isaacwkz/Robotic-Arm-with-Moving-Platform/Mechanics/Wheel Hub.stl

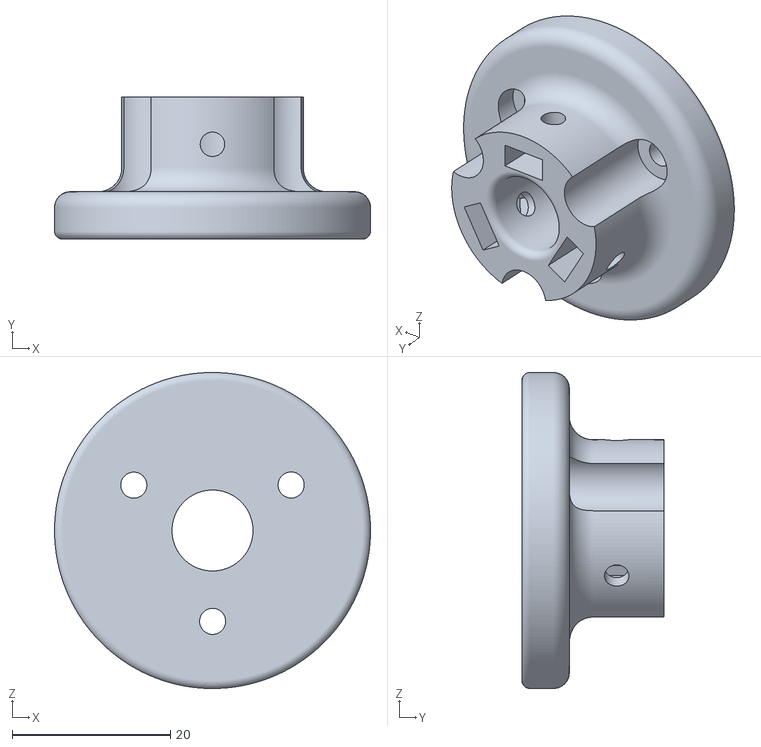
[picture p2: CAD file, 2020-05-06]
Mechanics/Wheel Hub.stl
40.0 x 18.0 x 40.0
