isaacwkz/Robotic-Arm-with-Moving-Platform/Mechanics/Double Helix Servo Gear.stl

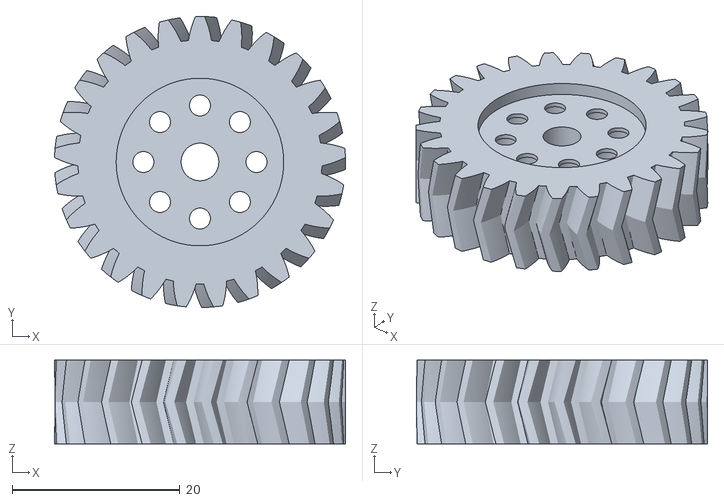
[picture p3: CAD file, 2020-04-30]
Mechanics/Double Helix Servo Gear.stl
34.7 x 34.8 x 10.0
