isaacwkz/Robotic-Arm-with-Moving-Platform/Mechanics/Swivel Joint Driver.stl

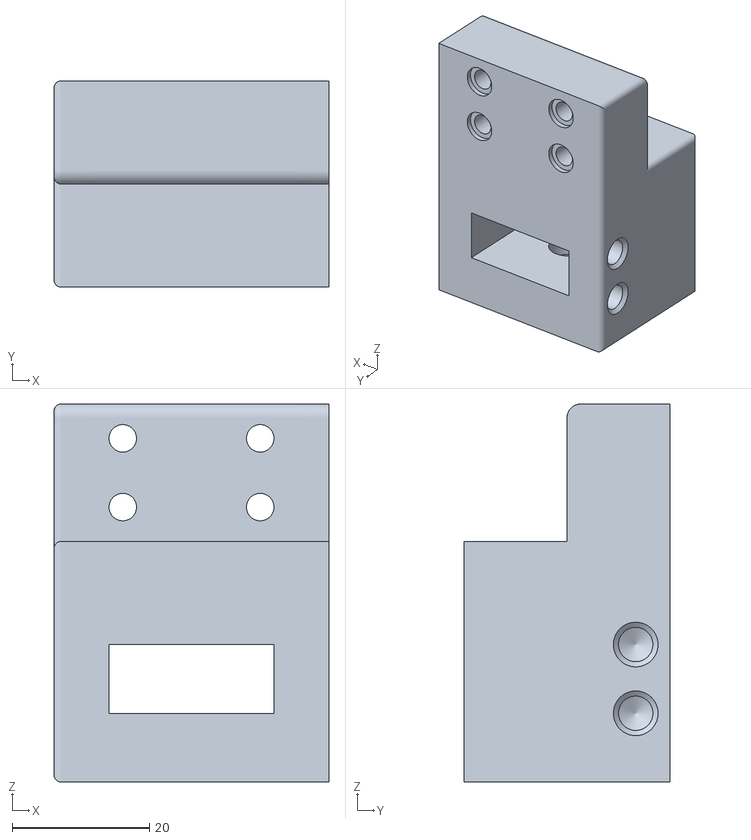
[picture p4: CAD file, 2020-04-30]
Mechanics/Swivel Joint Driver.stl
40.0 x 30.0 x 55.0
