isaacwkz/Robotic-Arm-with-Moving-Platform/Mechanics/Swivel Joint Servo Gear.stl

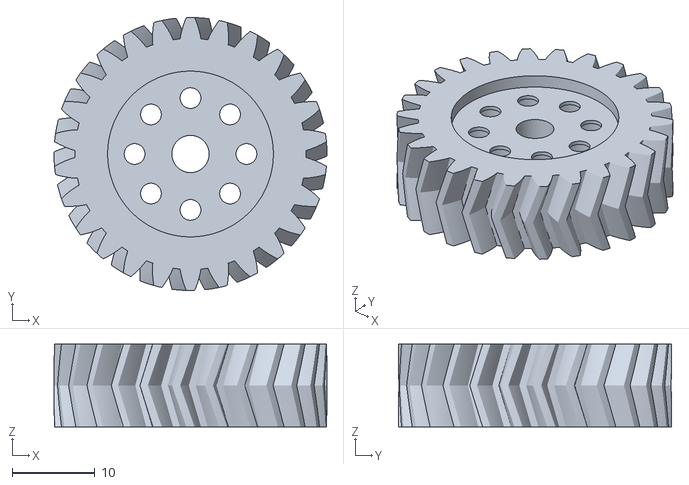
[picture p5: CAD file, 2020-04-30]
Mechanics/Swivel Joint Servo Gear.stl
32.9 x 32.9 x 10.0
