isaacwkz/Robotic-Arm-with-Moving-Platform/Mechanics/Double Helix Driven Gear.stl

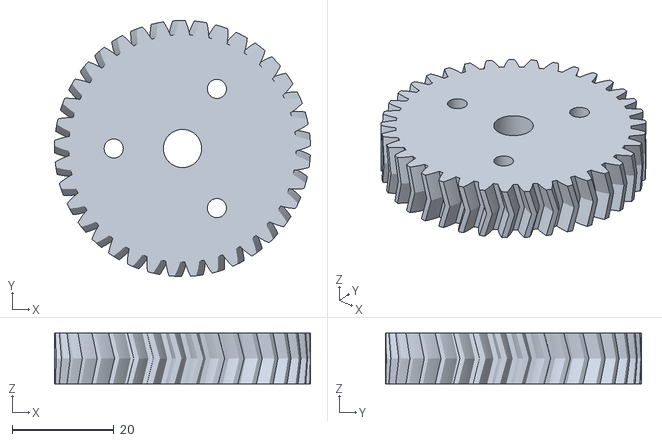
[picture p6: CAD file, 2020-04-30]
Mechanics/Double Helix Driven Gear.stl
50.2 x 50.2 x 10.0
