isaacwkz/Robotic-Arm-with-Moving-Platform/Mechanics/Swivel Arm Servo Holder.stl

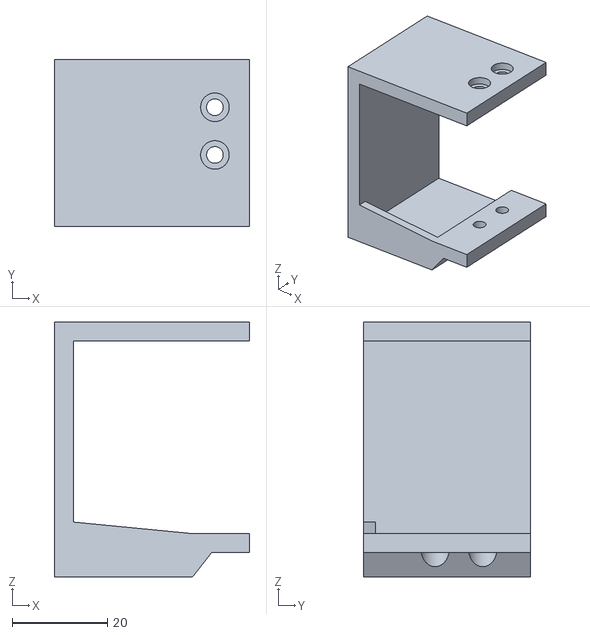
[picture p7: CAD file, 2020-04-30]
Mechanics/Swivel Arm Servo Holder.stl
41.0 x 35.0 x 53.5
