isaacwkz/Robotic-Arm-with-Moving-Platform/Mechanics/Servo Joint.stl

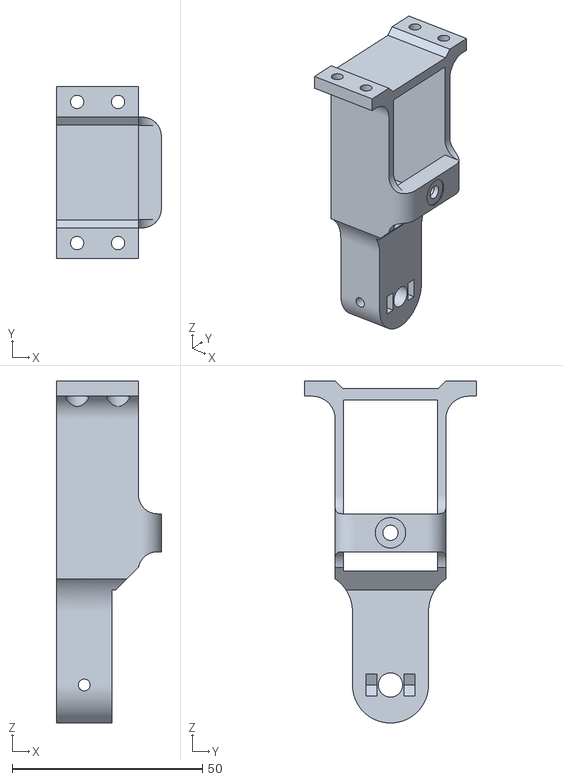
[picture p8: CAD file, 2020-04-30]
Mechanics/Servo Joint.stl
27.5 x 45.1 x 89.9
