isaacwkz/Robotic-Arm-with-Moving-Platform/Mechanics/Swivel Joint Driven.stl

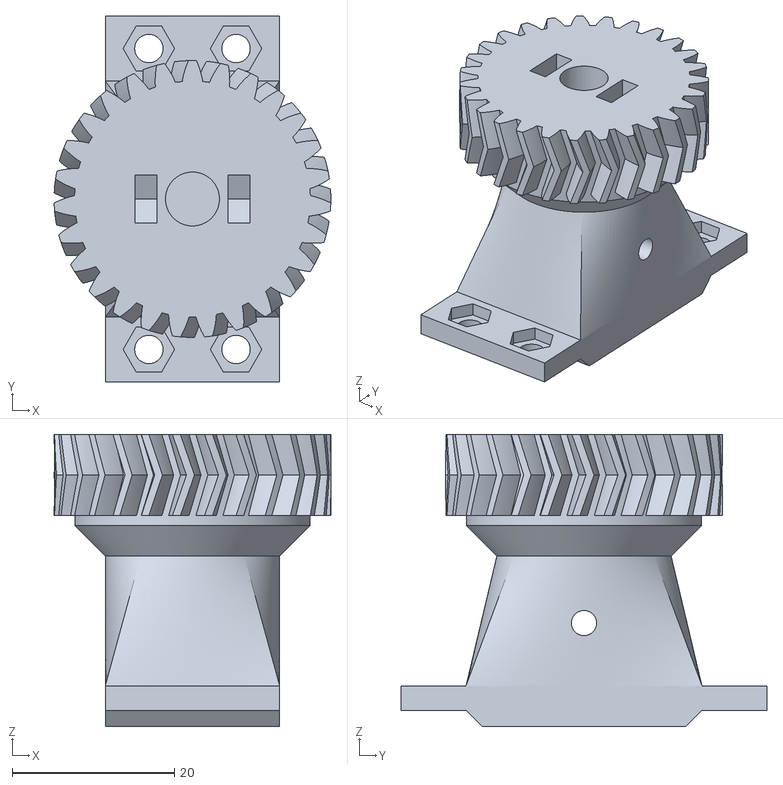
[picture p9: CAD file, 2020-04-30]
Mechanics/Swivel Joint Driven.stl
34.1 x 45.1 x 36.0
