isaacwkz/Robotic-Arm-with-Moving-Platform/Mechanics/Test Stand.stl

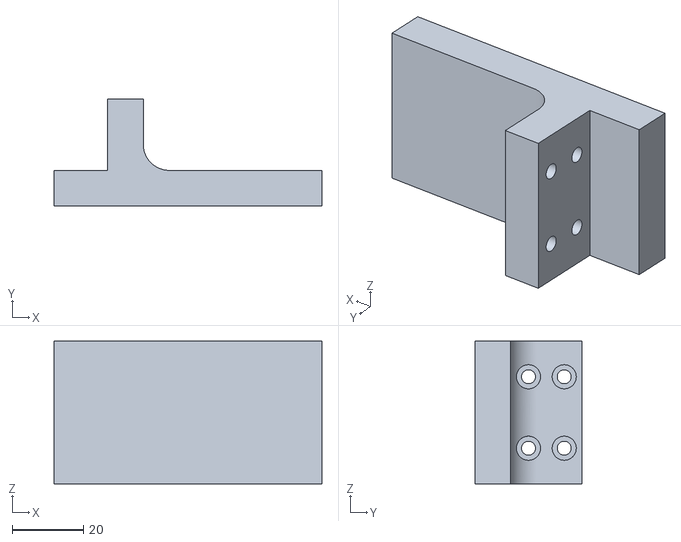
[picture p10: CAD file, 2020-04-30]
Mechanics/Test Stand.stl
75.0 x 30.0 x 40.0
