isaacwkz/Robotic-Arm-with-Moving-Platform/Mechanics/Arm Joint Brass Insert.stl

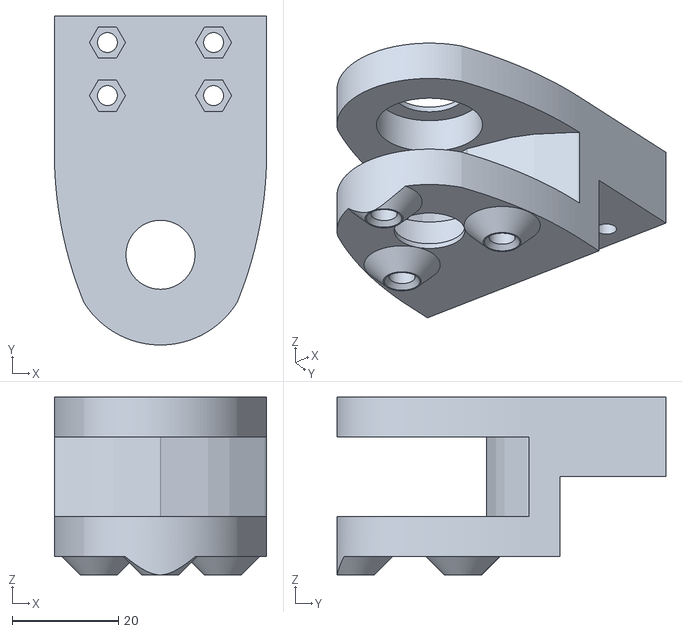
[picture p11: CAD file, 2020-04-30]
Mechanics/Arm Joint Brass Insert.stl
40.0 x 62.0 x 33.5
