isaacwkz/Robotic-Arm-with-Moving-Platform/Mechanics/Swivel Joint Axle Lock.stl

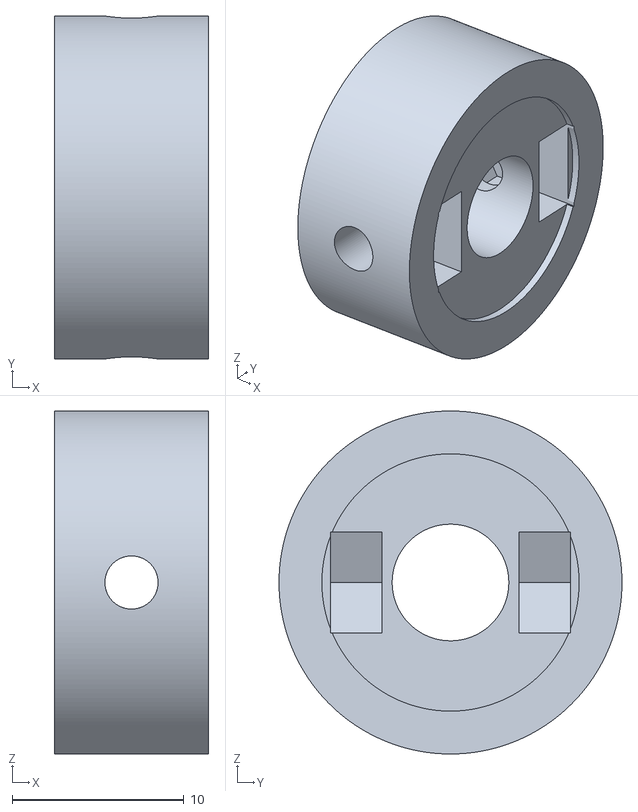
[picture p12: CAD file, 2020-04-30]
Mechanics/Swivel Joint Axle Lock.stl
9.00 x 20.0 x 20.0
