isaacwkz/Robotic-Arm-with-Moving-Platform/Mechanics/Driven Gear.stl

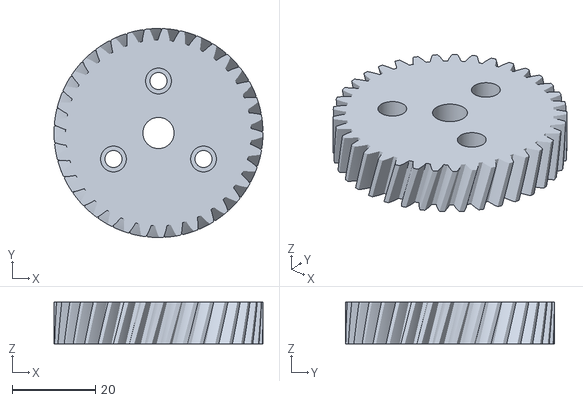
[picture p13: CAD file, 2020-04-30]
Mechanics/Driven Gear.stl
50.2 x 50.2 x 10.0
