isaacwkz/Robotic-Arm-with-Moving-Platform/Mechanics/Servo Gear.stl

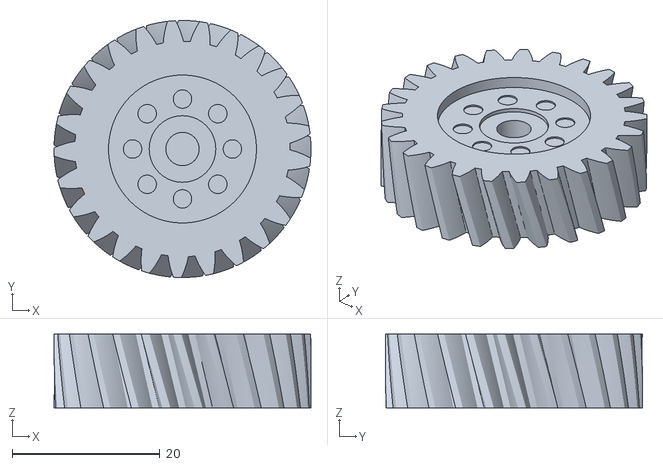
[picture p14: CAD file, 2020-04-30]
Mechanics/Servo Gear.stl
34.8 x 34.8 x 10.0
