isaacwkz/Robotic-Arm-with-Moving-Platform/(list of files, cad)

Other CAD files:
Mechanics/Driven Gear M4.stl
Mechanics/Arm Joint.stl
Mechanics/Arm Joint Brass Insert.ipt
Mechanics/Arm Joint.ipt
Mechanics/Assembly.iam
Mechanics/Double Helix Driven Gear.ipt
Mechanics/Double Helix Servo Gear.ipt
Mechanics/Driven Gear M4.ipt
Mechanics/Driven Gear.ipt
Mechanics/Gear Joint.iam
Mechanics/LX-16A.ipt
Mechanics/OldVersions/Arm Joint Brass Insert.0001.ipt
Mechanics/OldVersions/Arm Joint.0007.ipt
Mechanics/OldVersions/Assembly.0012.iam
Mechanics/OldVersions/Double Helix Driven Gear M4.0005.ipt
Mechanics/OldVersions/Double Helix Driven Gear.0001.ipt
Mechanics/OldVersions/Double Helix Servo Gear.0001.ipt
Mechanics/OldVersions/Driven Gear M4.0004.ipt
Mechanics/OldVersions/Driven Gear.0002.ipt
Mechanics/OldVersions/Servo Gear.0008.ipt
Mechanics/OldVersions/Servo Joint.0012.ipt
Mechanics/OldVersions/Swivel Arm Servo Holder.0004.ipt
Mechanics/OldVersions/Swivel Joint Axle Lock Grub Screw.0001.ipt
Mechanics/OldVersions/Swivel Joint Axle Lock Side A.0004.ipt
Mechanics/OldVersions/Swivel Joint Axle Lock Side B.0002.ipt
Mechanics/OldVersions/Swivel Joint Axle Lock.0004.ipt
Mechanics/OldVersions/Swivel Joint Driven Axle Lock.0001.ipt
Mechanics/OldVersions/Swivel Joint Driven Axle Lock.0002.ipt
Mechanics/OldVersions/Swivel Joint Driven.0008.ipt
Mechanics/OldVersions/Swivel Joint Driver.0003.ipt
Mechanics/OldVersions/Swivel Joint Driver.0005.ipt
Mechanics/OldVersions/Swivel Joint Gears.0001.iam
Mechanics/OldVersions/Swivel Joint Servo Gear.0003.ipt
Mechanics/OldVersions/Wheel Hub.0007.ipt
Mechanics/Servo Gear.ipt
Mechanics/Servo Joint.ipt
Mechanics/Swivel Arm Servo Assembly.iam
Mechanics/Swivel Arm Servo Holder.ipt
Mechanics/Swivel Joint Axle Lock Grub Screw.ipt
Mechanics/Swivel Joint Driven Gear.ipt
Mechanics/Swivel Joint Driven.ipt
Mechanics/Swivel Joint Driver.ipt
Mechanics/Swivel Joint Gears.iam
Mechanics/Swivel Joint Servo Gear.ipt
Mechanics/Test Stand.ipt
Mechanics/Wheel Hub.ipt
Mechanics/joint.iam
