isaacwkz/Robotic-Arm-with-Moving-Platform/Electronics/Hardware/PCB Schematics/Robot Controller R2.pdf

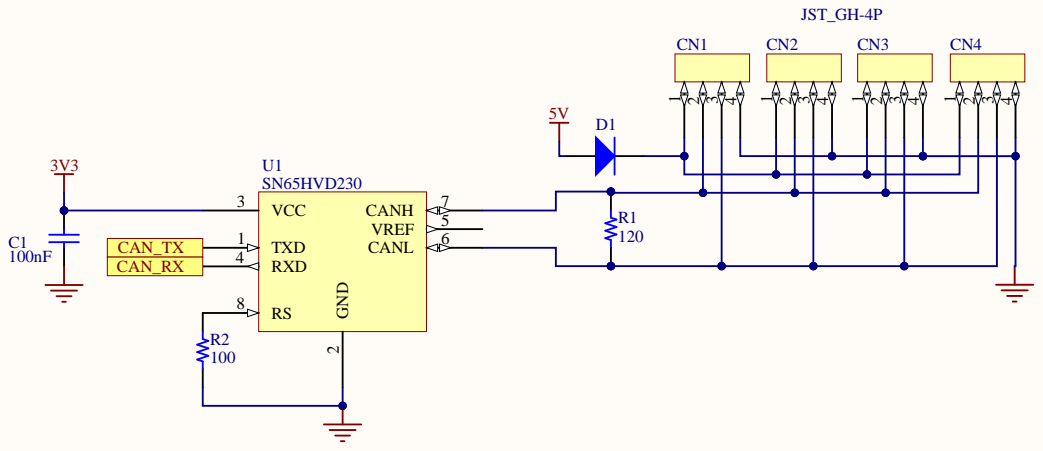
[picture p15: page 1]

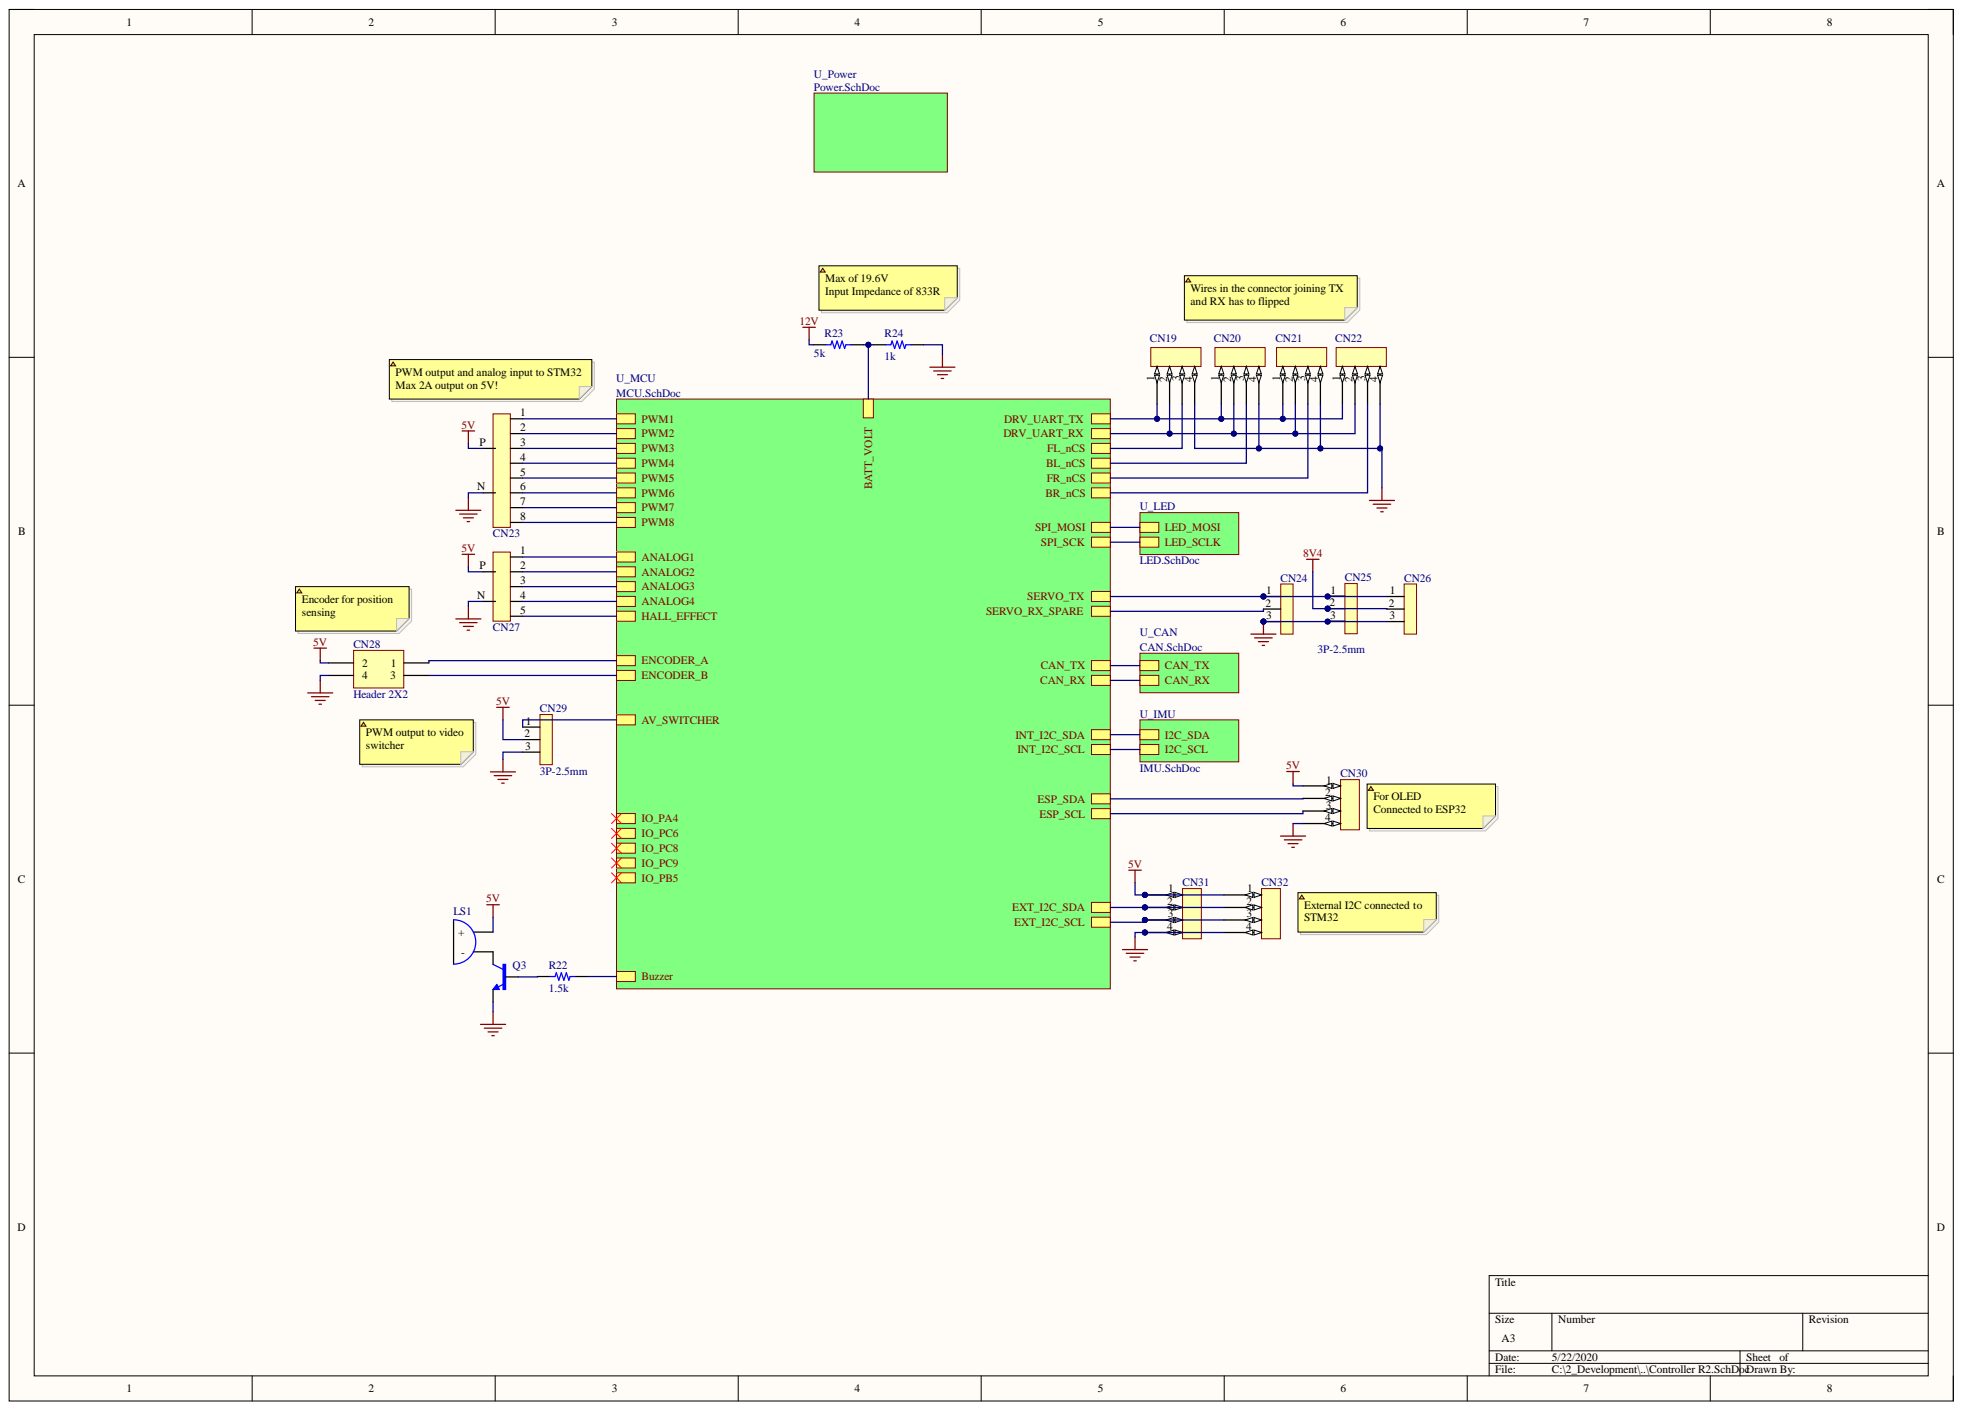
[picture p16: page 2]

Wires in the connector joining TX
and RX has to flipped

PWM output and analog input to STM32
Max 2A output on 5V!

2 | LED.SchDoc
3 | | CN25

PWM output to video
switcher

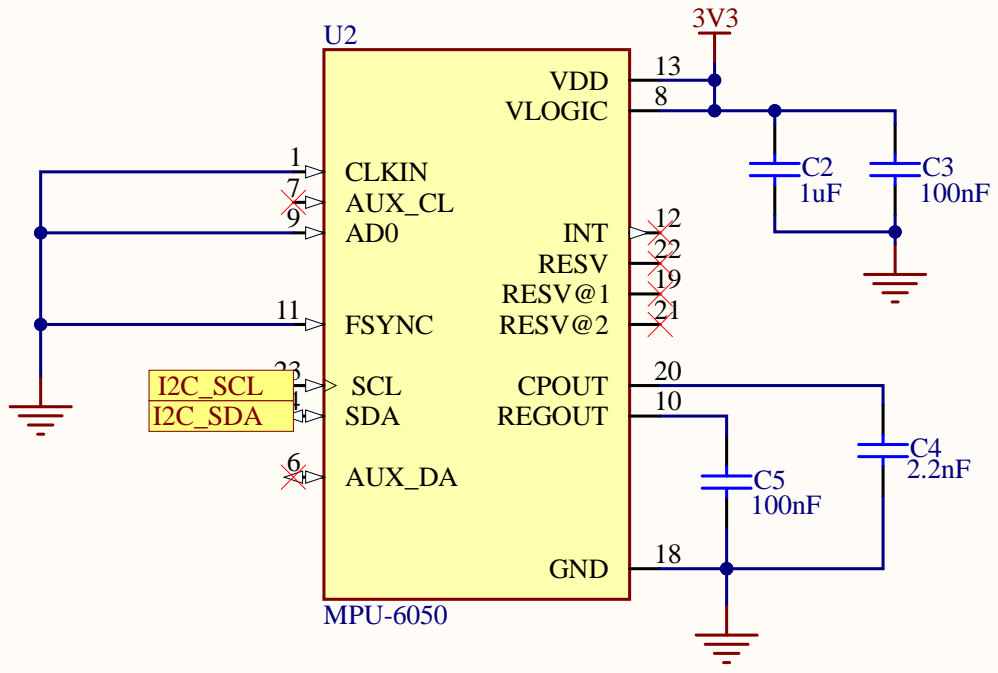
[picture p17: page 3]

I2C_SCL

SCL 23

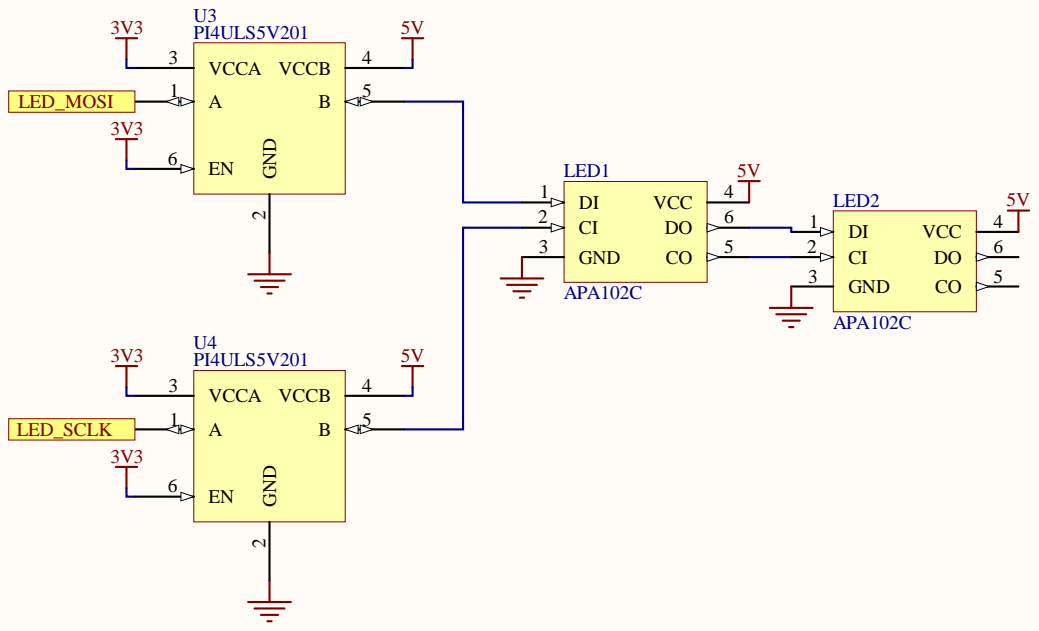
[picture p18: page 4]

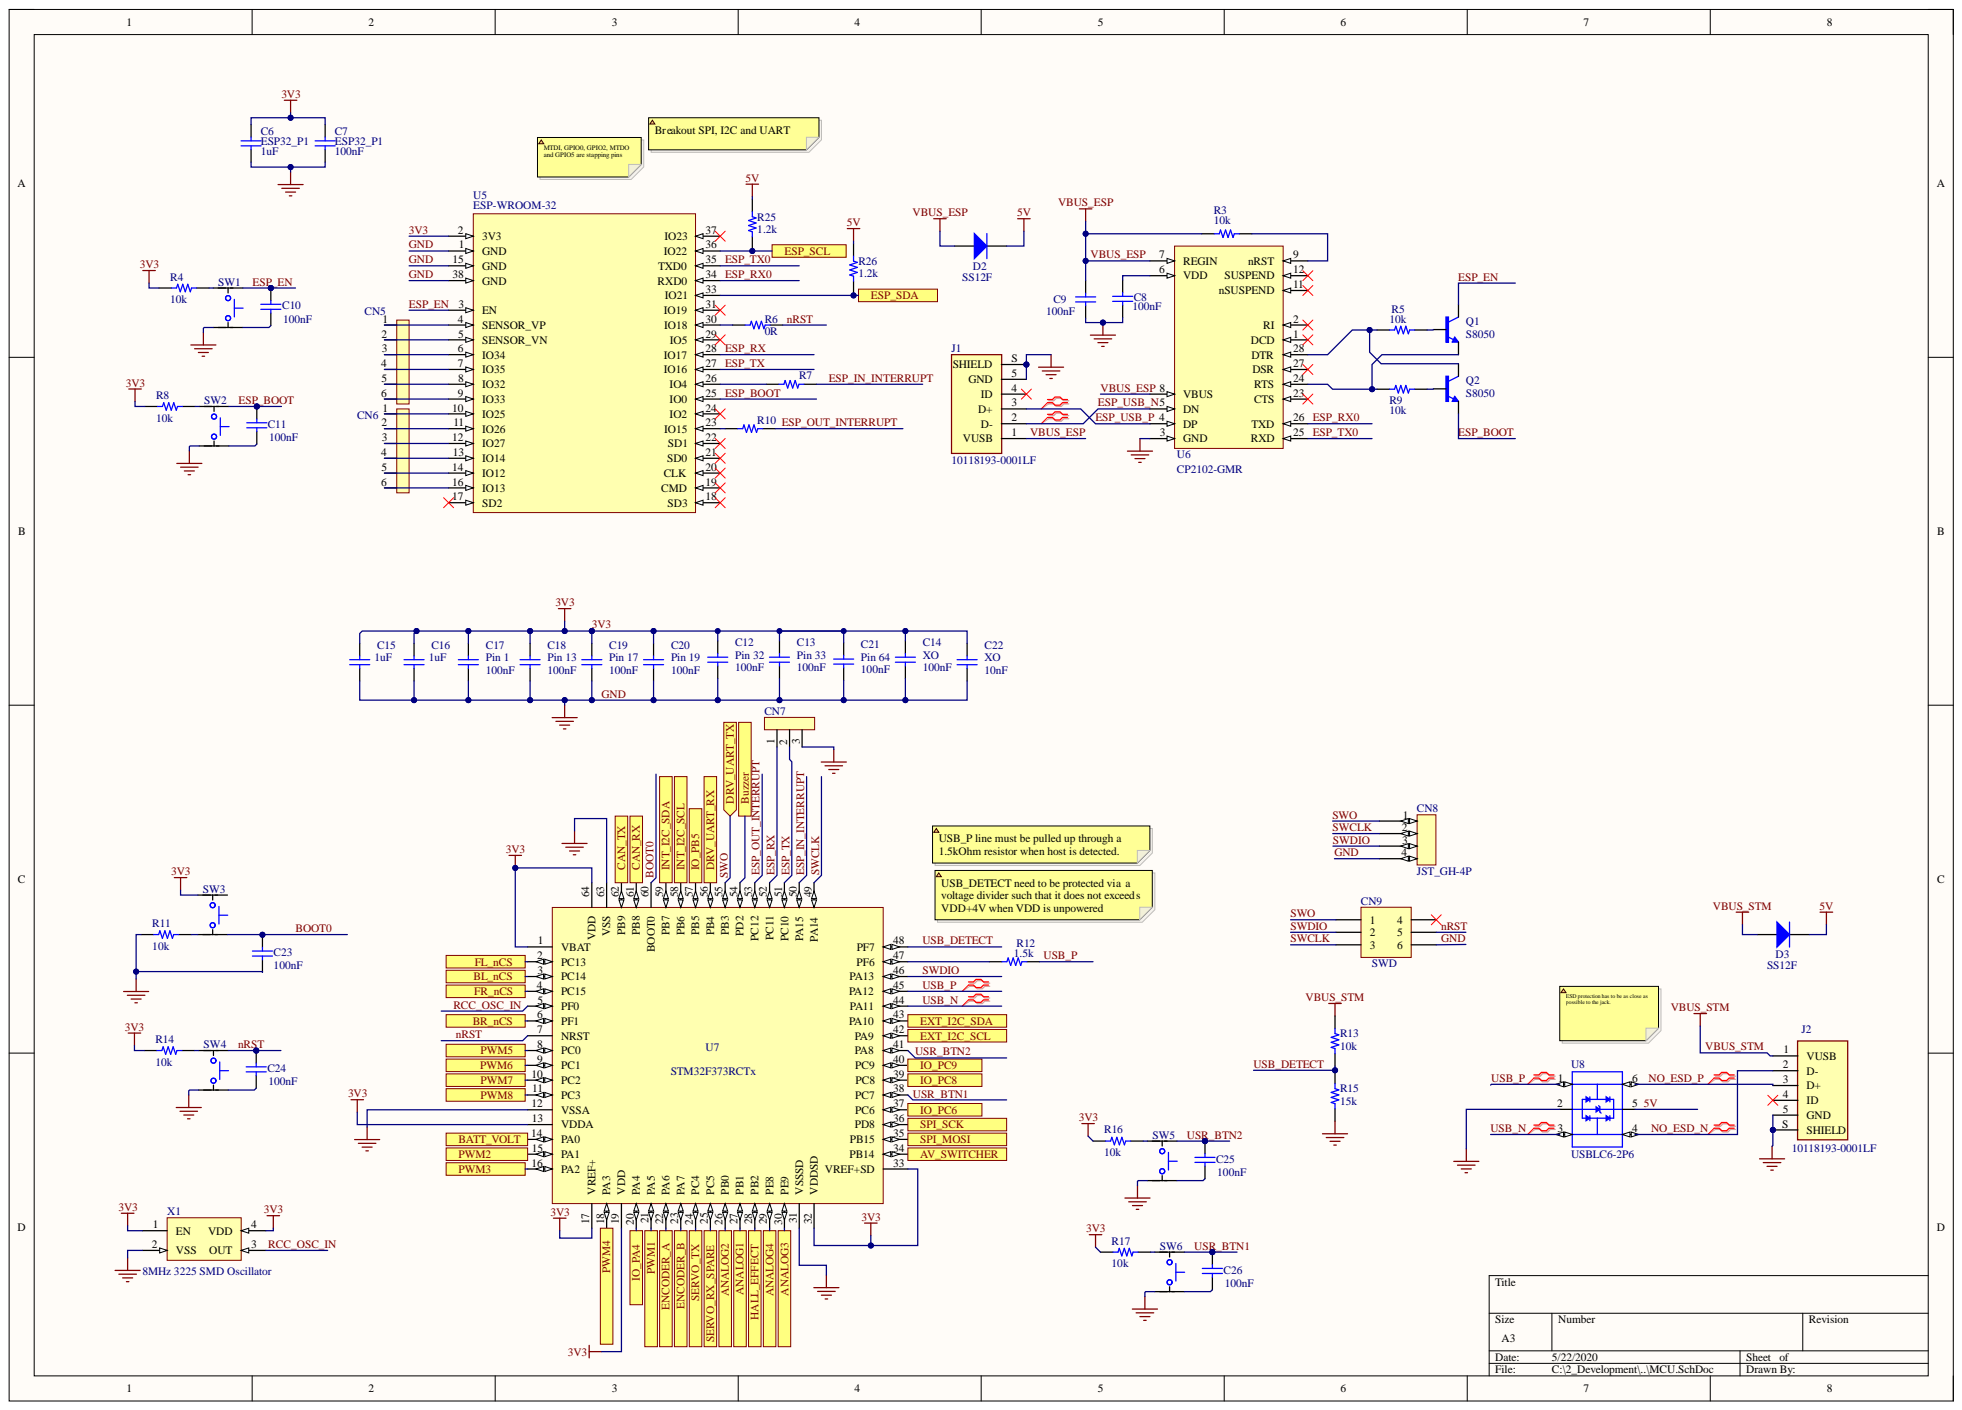
[picture p19: page 5]

Breakout SPI, I2C and UART

MTDI, GPIO0, GPIO2, MTDO
and GPIO5 are stapping pins

USB_P line must be pulled up through a
1.5kOhm resistor when host is detected.

USB_DETECT need to be protected via a
voltage divider such that it does not exceeds
VDD+4V when VDD is unpowered

BL_nCS | PC15 4

ESD protection has to be as close as
possible to the jack.

BATT_VOLT | SPI_MOSI
PWM2 | AV_SWITCHER

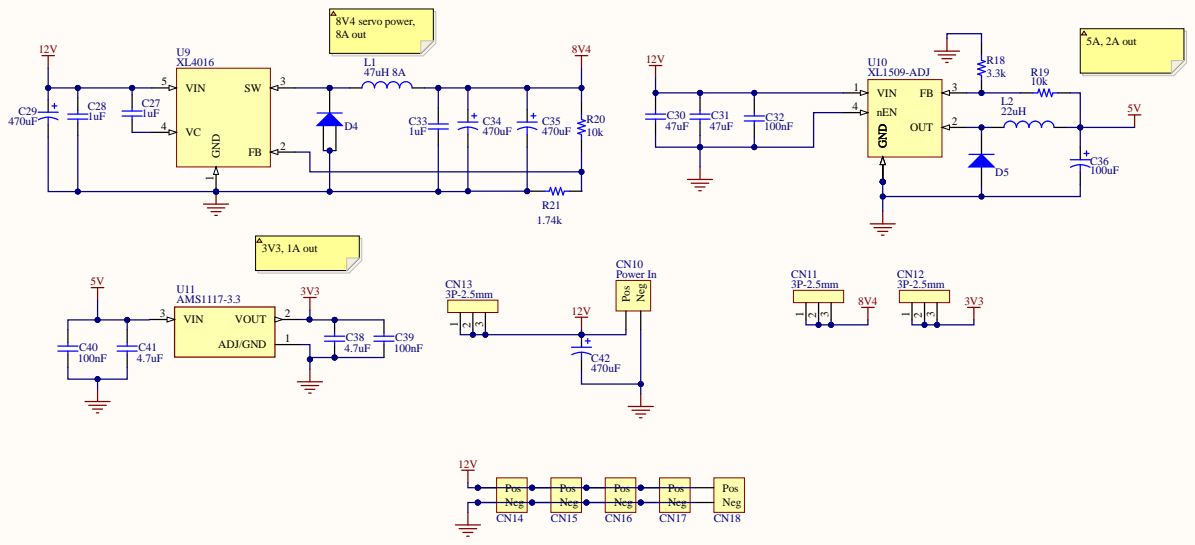
[picture p20: page 6]

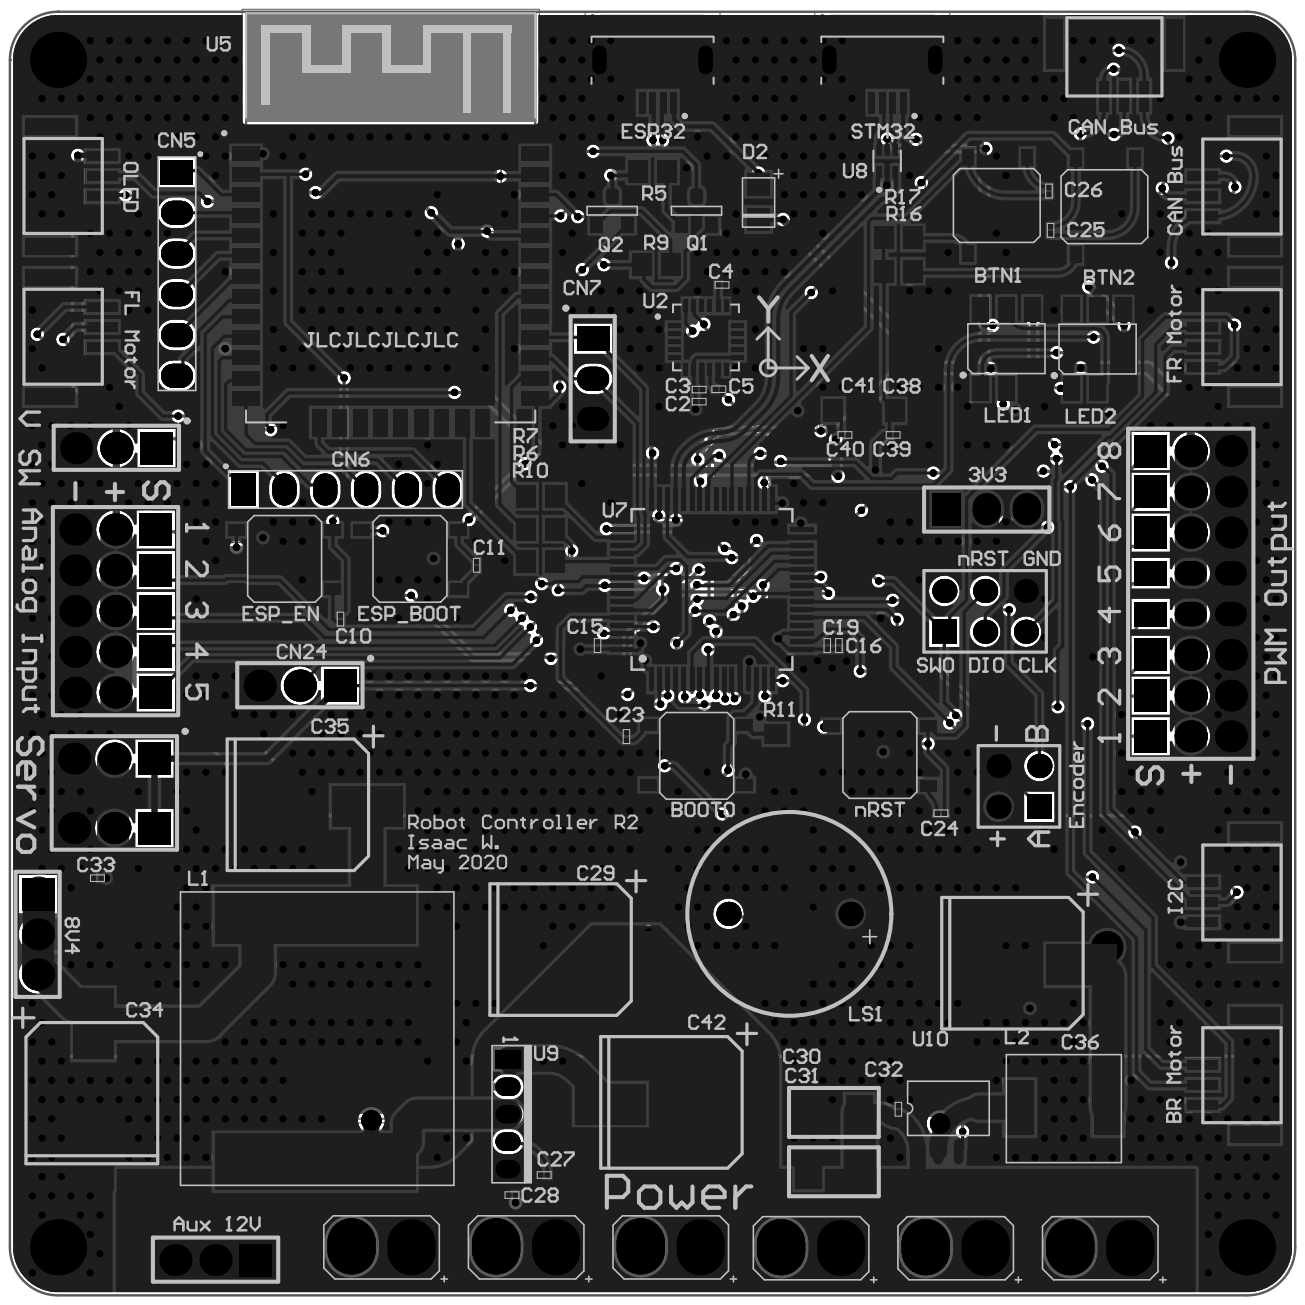
[picture p21: page 7]
