isaacwkz/Robotic-Arm-with-Moving-Platform/Electronics/Hardware/PCB Schematics/DC_ESC.pdf

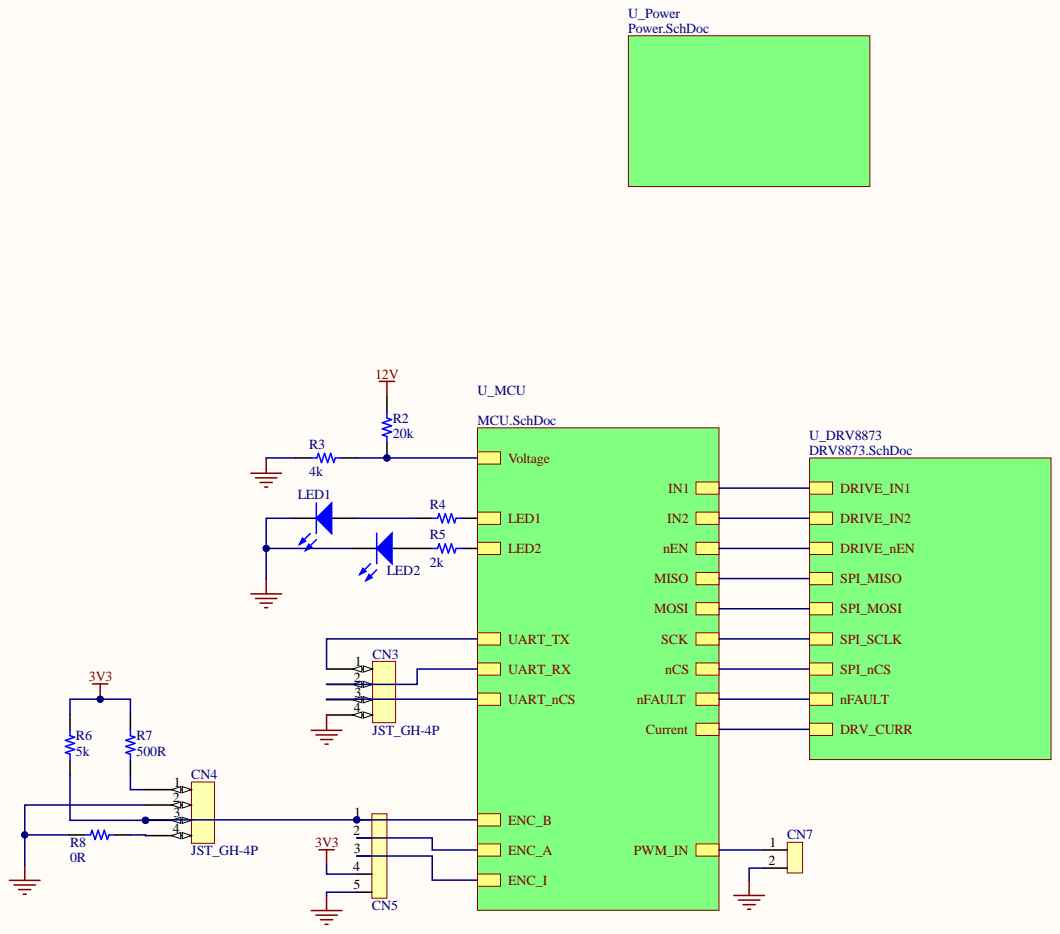
[picture p22: page 1]

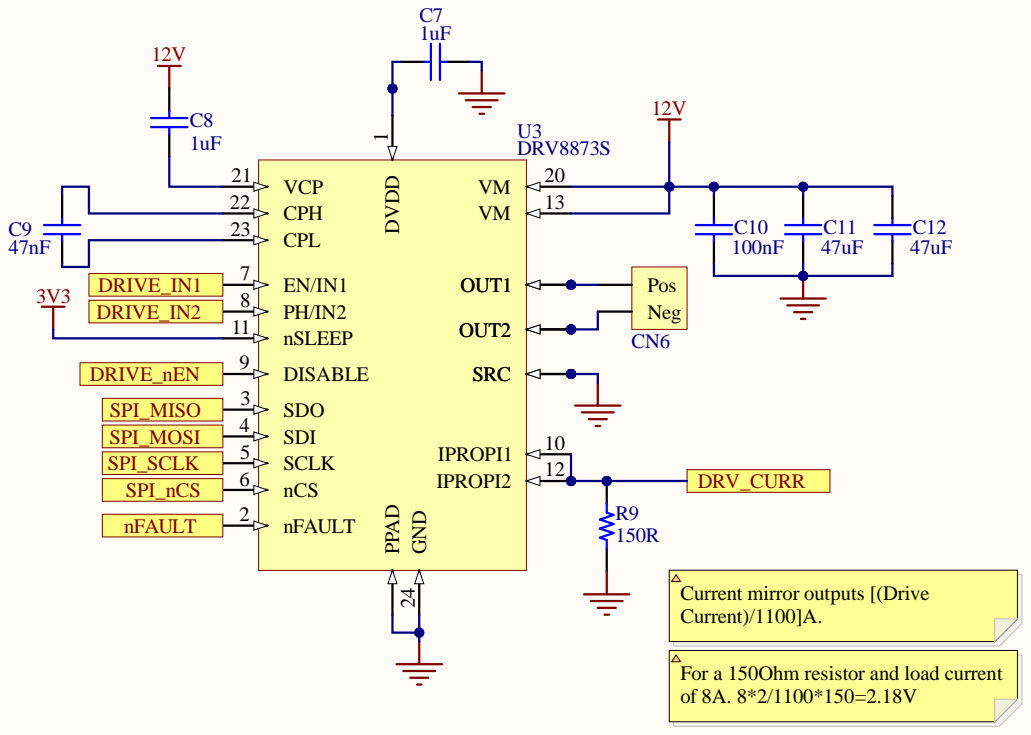
[picture p23: page 2]

DISABLE 9

DRIVE_nEN | SDO 3
SPI_MISO | SDI 4

SPI_nCS | | nFAULT 2

nCS 6 | | DRV_CURR

Current mirror outputs [(Drive
Current)/1100]A.

For a 150Ohm resistor and load current

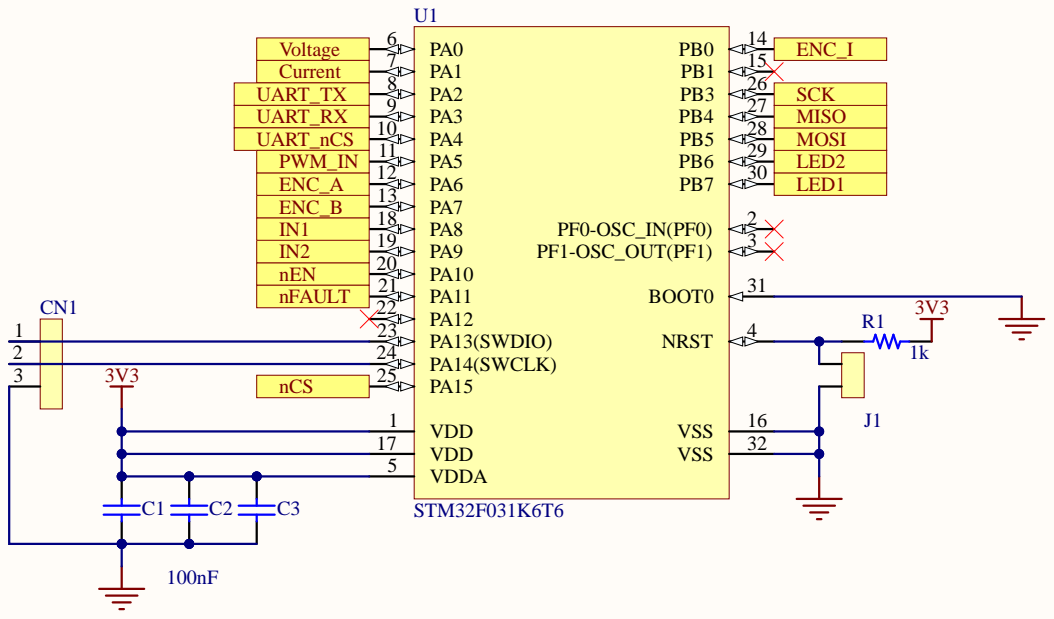
[picture p24: page 3]

UA RT_nCS | MOS I
PWM_I N | LED1 LED2

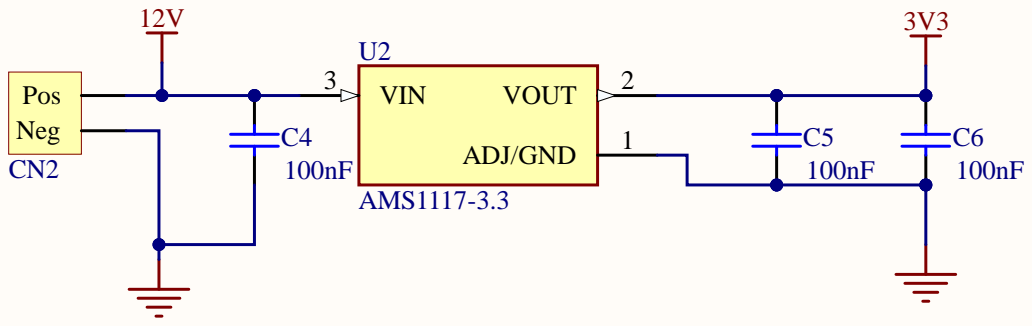
[picture p25: page 4]

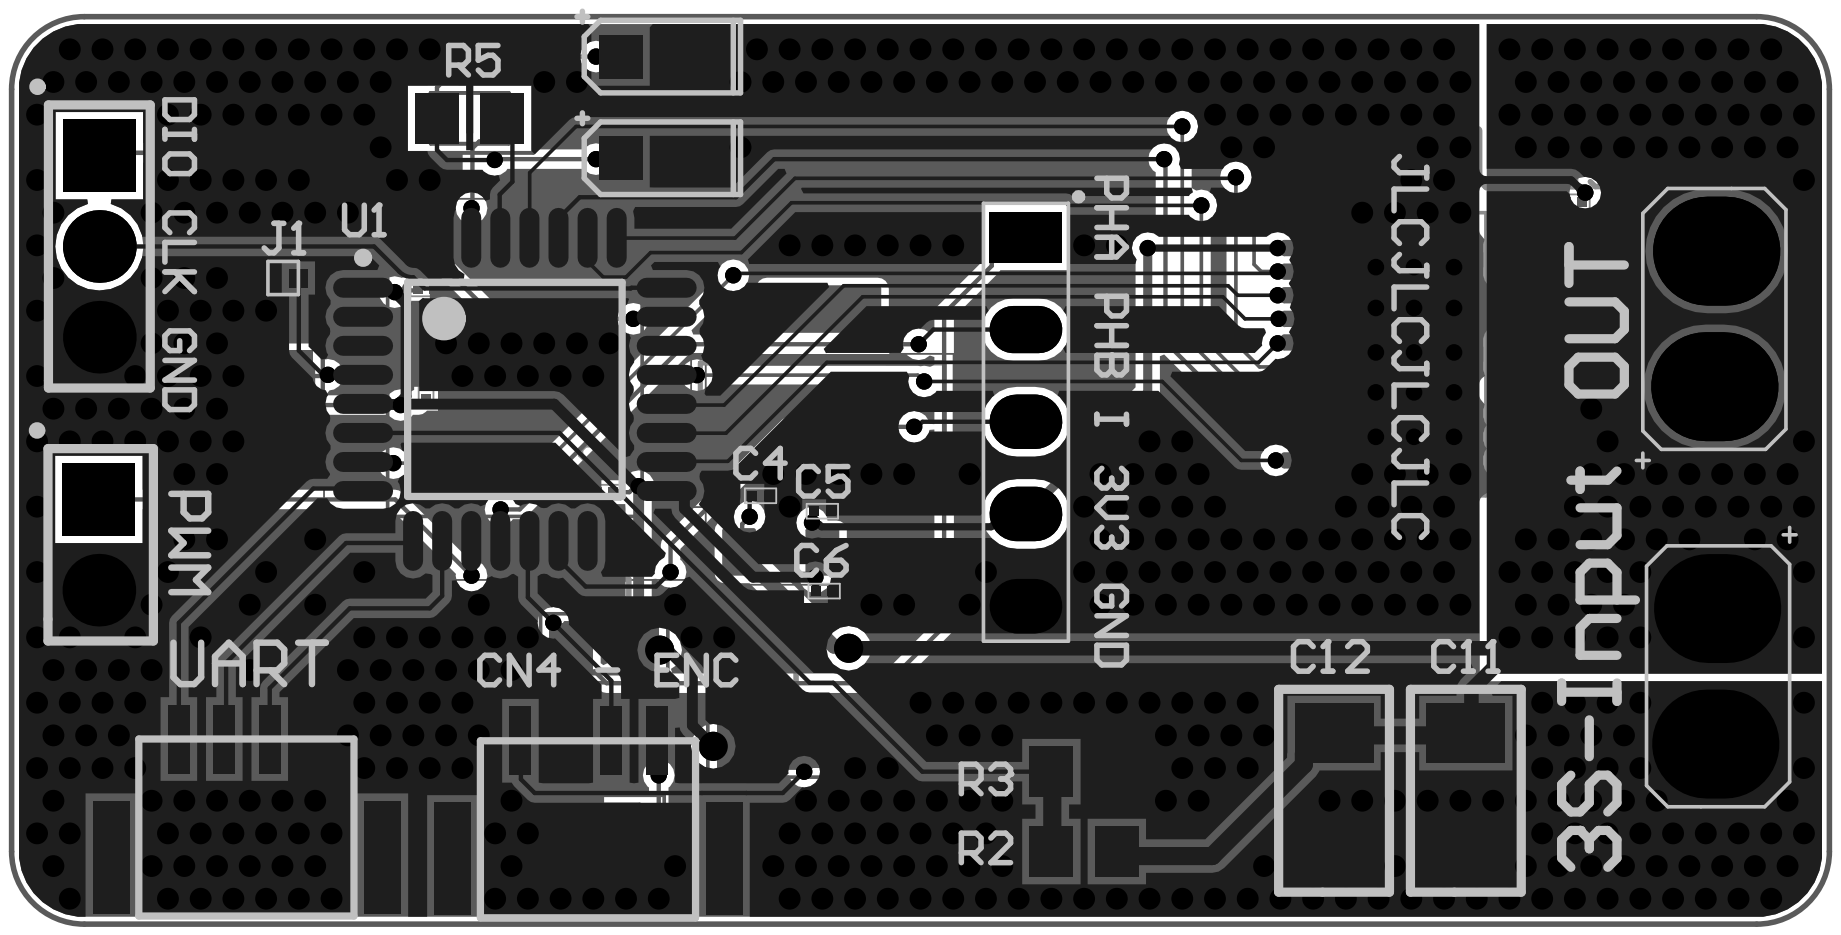
[picture p26: page 5]
