isaacwkz/Robotic-Arm-with-Moving-Platform/(list of files, drawings)

Other design files:
Electronics/Hardware/Controller R1/CAN.SchDoc
Electronics/Hardware/Controller R1/Controller.PcbDoc
Electronics/Hardware/Controller R1/Controller.SchDoc
Electronics/Hardware/Controller R1/Drive.SchDoc
Electronics/Hardware/Controller R1/DRV8843.SchDoc
Electronics/Hardware/Controller R1/IMU.SchDoc
Electronics/Hardware/Controller R1/LED.SchDoc
Electronics/Hardware/Controller R1/MCU.SchDoc
Electronics/Hardware/Controller R1/Power.SchDoc
Electronics/Hardware/Controller R1/Robot Controller.PrjPCB
Electronics/Hardware/Controller R1/Symbols and Footprints/Parts.PcbLib
Electronics/Hardware/Controller R1/Symbols and Footprints/Parts.SchLib
Electronics/Hardware/Controller R1/TMC7300.SchDoc
Electronics/Hardware/Controller R2/CAN.SchDoc
Electronics/Hardware/Controller R2/Controller R2.PcbDoc
Electronics/Hardware/Controller R2/Controller R2.PrjPcb
Electronics/Hardware/Controller R2/Controller R2.SchDoc
Electronics/Hardware/Controller R2/IMU.SchDoc
Electronics/Hardware/Controller R2/LED.SchDoc
Electronics/Hardware/Controller R2/MCU.SchDoc
Electronics/Hardware/Controller R2/Power.SchDoc
Electronics/Hardware/Controller R2/Symbols and Footprints/Imported ESP-WROOM-32.lia/ESP-WROOM-32.PcbLib
Electronics/Hardware/Controller R2/Symbols and Footprints/Imported ESP-WROOM-32.lia/ESP-WROOM-32.SchLib
Electronics/Hardware/Controller R2/Symbols and Footprints/Parts.PcbLib
Electronics/Hardware/Controller R2/Symbols and Footprints/Parts.SchLib
Electronics/Hardware/DC_ESC/DC_ESC.PrjPcb
Electronics/Hardware/DC_ESC/DRV8873.SchDoc
Electronics/Hardware/DC_ESC/ESC.PcbDoc
Electronics/Hardware/DC_ESC/ESC.SchDoc
Electronics/Hardware/DC_ESC/MCU.SchDoc
Electronics/Hardware/DC_ESC/Power.SchDoc
Electronics/Hardware/DC_ESC/Symbols and Footprints/Parts.PcbLib
Electronics/Hardware/DC_ESC/Symbols and Footprints/Parts.SchLib
