isaacwkz/Robotic-Arm-with-Moving-Platform/Electronics/Software/Controller/Controller.ioc

Mcu.UserName=STM32F373RCTx
PA0.GPIO_Label=BATT_VOLT
PA0.Signal=ADC1_IN0
PA1.GPIO_Label=PWM2
PA1.Signal=S_TIM2_CH2
PA10.GPIO_Label=EXT_I2C_SDA
PA10.Signal=I2C2_SDA
PA11.Signal=USB_DM
PA12.Signal=USB_DP
PA13.Signal=SYS_JTMS-SWDIO
PA14.Signal=SYS_JTCK-SWCLK
PA15.GPIO_Label=ESP_IN_INTERRUPT
PA15.Signal=GPXTI15
PA2.GPIO_Label=PWM3
PA2.Signal=S_TIM2_CH3
PA3.GPIO_Label=PWM4
PA3.Signal=S_TIM2_CH4
PA5.GPIO_Label=PWM1
PA5.Signal=S_TIM2_CH1_ETR
PA6.GPIO_Label=ENCODER_A
PA6.Signal=S_TIM3_CH1
PA7.GPIO_Label=ENCODER_B
PA7.Signal=S_TIM3_CH2
PA8.GPIO_Label=USR_BTN2
PA8.Signal=GPIO_Input
PA9.GPIO_Label=EXT_I2C_SCL
PA9.Signal=I2C2_SCL
PB0.GPIO_Label=ANALOG2
PB0.Signal=SDADC1_AIN6P
PB1.GPIO_Label=ANALOG1
PB1.Signal=SDADC1_AIN5P
PB14.GPIO_Label=AV_SWITCHER
PB14.Signal=S_TIM12_CH1
PB15.GPIO_Label=SPI_MOSI
PB15.Signal=SPI2_MOSI
PB2.GPIO_Label=HALL_EFFECT
PB2.Signal=SDADC1_AIN4P
PB3.GPIO_Label=DRIVE_UART_TX
PB3.Signal=USART2_TX
PB4.GPIO_Label=DRIVE_UART_RX
PB4.Signal=USART2_RX
PB6.GPIO_Label=INT_I2C_SCL
PB6.Signal=I2C1_SCL
PB7.GPIO_Label=INT_I2C_SDA
PB7.Signal=I2C1_SDA
PB8.Signal=CAN_RX
PB9.Signal=CAN_TX
PC0.GPIO_Label=PWM5
PC0.Signal=S_TIM5_CH1_ETR
PC1.GPIO_Label=PWM6
PC1.Signal=S_TIM5_CH2
PC10.GPIO_Label=ESP_TX
PC10.Signal=USART3_TX
PC11.GPIO_Label=ESP_RX
PC11.Signal=USART3_RX
PC12.GPIO_Label=ESP_OUT_INTERRUPT
PC12.Signal=GPIO_Output
PC13.GPIO_Label=FL_nCS
PC13.Signal=GPIO_Output
PC14-OSC32_IN.Signal=GPIO_Output
PC15-OSC32_OUT.GPIO_Label=FR_nCS
PC15-OSC32_OUT.Signal=GPIO_Output
PC2.GPIO_Label=PWM7
PC2.Signal=S_TIM5_CH3
PC3.GPIO_Label=PWM8
PC3.Signal=S_TIM5_CH4
PC4.GPIO_Label=SERVO_TX
PC4.Signal=USART1_TX
PC5.GPIO_Label=SERVO_RX_SPARE
PC5.Signal=GPIO_Analog
PC7.Signal=GPIO_Input
PD2.GPIO_Label=Buzzer
PD2.Signal=GPIO_Output
PD8.GPIO_Label=SPI_SCK
PD8.Signal=SPI2_SCK
PE8.GPIO_Label=ANALOG4
PE8.Signal=SDADC1_AIN8P
PE9.GPIO_Label=ANALOG3
PE9.Signal=SDADC1_AIN7P
PF0-OSC_IN.Signal=RCC_OSC_IN
PF1-OSC_OUT.GPIO_Label=BR_nCS
PF1-OSC_OUT.Signal=GPIO_Output
PF6.GPIO_Label=USB_DP_PULLUP
PF6.Signal=GPIO_Output
PF7.GPIO_Label=USB_DETECT
PF7.Signal=GPIO_Output
