isaacwkz/Robotic-Arm-with-Moving-Platform/(commit log)

2020-05-01 Added PDF export of PCB
    [Copy of Controller.PcbDoc]
2020-05-02 Updateed PCB Clearances
    [Robot Controller.PrjPCB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]
2020-05-06 unrouted PCB, added screenshots of mechanics
    [Robot Controller.PrjPCB, Wheel Hub.0007.ipt, Wheel Hub.ipt, Wheel Hub.stl]
2020-05-06 scraped pcb
    [Controller.PcbDoc, Parts.PcbLib]
2020-05-13 PCB edits
    Old controller has been scraped (marked as R1)
    Motor drivers has been seperated out on a different PCB.
    [CAN.SchDoc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]
2020-05-15 PCB edits
    [CAN.SchDoc, Controller R2.PcbDoc, Controller R2.PrjPcb, Controller R2.SchDoc, ESP-WROOM-32.PcbLib, ESP-WROOM-32.SchLib, IMU.SchDoc, LED.SchDoc]
2020-05-15 more PCB edtis
    [Controller R2.PcbDoc, Controller R2.PrjPcb, MCU.SchDoc]
2020-05-20 PCB edits before changing to a 4 layer stackup
    [Controller R2.SchDoc, Parts.PcbLib]
2020-05-22 FInalised PCB design
2020-05-22 Cleaned up folder
    [Controller R2.PcbDoc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]
